bazauto/PicoDCC/docs/dccex-compliance-analysis.md

# PicoDCC DCC-EX Specification Compliance Analysis

**Reviewed against `main`**: 2026-08-20

> The authoritative list of what actually parses is the opcode table in
> [`architecture.md`](architecture.md), derived directly from
> `lib/PicoDCCEX/pico_dccexpacket.cpp`. This document gives the reasoning and the gap analysis;
> where the two disagree, the code wins.

## Overview
This document validates the PicoDCC project implementation against the [DCC-EX Native Commands Summary Reference](https://dcc-ex.com/reference/software/command-summary-consolidated.html). The analysis focuses on implemented features and identifies areas for future development.

## DCC-EX Protocol Commands Implemented ✅

### Power Management
**Status**: ✅ **IMPLEMENTED**

| Command | Description | Implementation Status | Location |
|---|---|---|---|
| `<0>` | Turn power off to all tracks | ✅ Implemented | `PicoDccExPacket::isPowerCommand()` |
| `<1>` | Turn power on to all tracks | ✅ Implemented | `PicoDccExPacket::isPowerCommand()` |
| `<0 MAIN>` | Turn off main track | ✅ Implemented | Track selection via `getTrack()` |
| `<1 MAIN>` | Turn on main track | ✅ Implemented | Track selection via `getTrack()` |
| `<0 PROG>` | Turn off prog track | ✅ Implemented | Track selection via `getTrack()` |
| `<1 PROG>` | Turn on prog track | ✅ Implemented | Track selection via `getTrack()` |

**Responses**: 
- ✅ `<p0>` / `<p1>` responses implemented via `getDccExPowerUpdate()`
- ✅ Track-specific responses: `<p1 MAIN>`, `<p1 PROG>`

**Implementation Details**:
- **Parser**: `PicoDccExPacket::decodePacket()` handles power commands
- **Execution**: `PicoDccController::dccexLoop()` processes power state changes
- **Hardware Control**: `PicoDccTrack::setPower()` controls GPIO pins

### Cab (Locomotive) Commands
**Status**: ✅ **CORE FEATURES IMPLEMENTED**

| Command | Description | Implementation Status | Location |
|---|---|---|---|
| `<t cab speed dir>` | Set locomotive speed/direction | ✅ Implemented | `PicoDccExPacket::isThrottleCommand()` |
| `<F cab funct state>` | Control locomotive functions | ✅ Implemented | `PicoDccExPacket::isFunctionCommand()` |
| `<!>` | Emergency stop all locomotives | ✅ Implemented | `PicoDccExPacket::isEmergencyStopCommand()` |

**Responses**:
- ✅ `<l cab 0 speed 0>` locomotive status responses via `getDccExCabUpdate()`
- ✅ Emergency stop sends `<l cab reg speedByte functMap>` for each active locomotive (DCC-EX compliant)
- ✅ `<O>` acknowledgment for accessory commands

**Implementation Details**:
- **Speed Control**: Full 0-126 speed range with direction bit
- **Function Control**: F0-F28 function support (RCN-212 compliant)
- **Emergency Stop**: Broadcast command (address 0x00, instruction 0x41)
- **Locomotive Management**: `PicoDccLocos` collection with automatic reminder system

### DCC Accessories
**Status**: ✅ **BASIC IMPLEMENTATION**

| Command | Description | Implementation Status | Location |
|---|---|---|---|
| `<a addr subaddr activate>` | Control accessory decoder | ✅ Implemented | `PicoDccExPacket::isAccesoryCommand()` |

**Responses**:
- ✅ `<O>` acknowledgment for accessory commands

**Implementation Details**:
- **Address/Subaddress Method**: Standard DCC accessory addressing
- **Raw Command Generation**: `getRawDccAccessoryCmd()` creates DCC packets

## DCC-EX Protocol Commands NOT Implemented ❌

### Track Manager Commands
**Status**: ❌ **NOT IMPLEMENTED**
- `<= trackletter mode [cab]>` - Configure Track Manager
- `<=>` - Request Track Manager configuration
- DC mode operations and frequency control

**Reason**: PicoDCC focuses on standard DCC operation, not multi-track management

### Configuration Variable (CV) Programming
**Status**: 🔄 **IN DEVELOPMENT**

| Command Category | Implementation Status | Notes |
|---|---|---|
| Programming Track CVs | 🔄 Infrastructure ready | `<W cv value>`, `<V cv value>`, `<R cv>`, `<B cv bit value>` |
| Main Track CV Programming | ❌ Not planned | `<w cab cv value>`, `<b cab cv bit value>` |
| CV Reading | 🔄 Infrastructure ready | ACK detection hardware in place |

**Implementation Status**:
- ✅ Hardware ACK detection ready (ADC-based current sensing)
- ✅ Programming track infrastructure (`PicoDccTrack` prog track)
- ✅ Method signatures defined in `PicoDccLoco` class
- ✅ Non-volatile storage for calibration values (`PicoConfigStorage`)
- 🔄 CV programming logic implementation in progress
- 🔄 DCC-EX CV command parsing in progress

### Programming Track Configuration Commands
**Status**: ✅ **IMPLEMENTED** (Runtime adjustable, persistable in maintenance mode)

| Command | Description | Implementation Status | Location |
|---|---|---|---|
| `<D ACK LIMIT mA>` | Set ACK detection current threshold | ✅ Implemented | Runtime config (default 60mA) |
| `<D ACK MIN us>` | Set minimum ACK pulse duration | ✅ Implemented | Runtime config (default 5000µs) |
| `<D ACK MAX us>` | Set maximum ACK pulse duration | ✅ Implemented | Runtime config (default 7000µs) |
| `<D SPEED28>` / `<D SPEED128>` | Select speed step mode | ✅ Implemented | 128 is the default. Extended with an optional trailing cab for a per-loco override, which DCC-EX does not have; the no-argument form JMRI sends is unchanged (#8) |

**Implementation Details**:
- **Runtime Adjustable**: Changes take effect immediately in RAM
- **Persistent Storage**: Saved to flash via `<E>` command (maintenance mode only)
- **Configuration Storage**: `PicoConfigStorage` manages NV storage in flash
- ⚠️ **ACK detection itself is not implemented on `main`.** These three commands tune and
  persist the *parameters* for it; nothing consumes them yet. The detection logic is being
  developed on the `programming` branch. Do not read "implemented" here as meaning a decoder
  acknowledgement can currently be detected.

**Not reachable**: `<D CONFIG ...>` and `<D CAL ...>` are implemented in
`lib/PicoDCCEX/pico_dccex_config.cpp` but never wired into the command path — the packet
validator accepts only `<D ACK ...>` and `<D SPEED28|SPEED128 [cab]>`. See
`docs/README.md` § Known gaps.

### EEPROM/Flash Storage Commands
**Status**: ✅ **IMPLEMENTED** (with safety restrictions)

| Command | Description | Implementation Status | Security |
|---|---|---|---|
| `<E>` | Save settings to flash/EEPROM | ✅ Implemented | 🔒 Maintenance mode only |

**Responses**:
- ✅ `<e SAVED>` - Flash write successful
- ✅ `<e FAILED>` - Flash write failed
- ✅ `<X>` - Command rejected (not in maintenance mode)

**Safety Design**:
- **Layout Maintenance Mode Required**: Prevents flash write during track operations
- **410ms Flash Write Block**: Both cores halt during write (all locos must be stopped)
- **Main Track Power Lockout**: Main track power disabled during maintenance mode
- **Programming Track Continues**: CV operations allowed during maintenance mode
- **LCD-Only Mode Entry**: Cannot enter maintenance mode via DCC-EX commands (operator presence required)

**Implementation Details**:
- **Flash Storage**: Last 4KB sector (0x101FF000) with CRC32 validation
- **Configuration Class**: `PicoConfigStorage` manages persistent parameters
- **Mode Management**: `PicoDCCController` enforces maintenance mode restrictions
- **Unsaved Changes Tracking**: System tracks runtime changes vs. flash-saved values

### System Information Commands
**Status**: ⚠️ **PARTIALLY IMPLEMENTED**

| Command | Description | Implementation Status | Notes |
|---|---|---|---|
| `<s>` | Version and hardware info | ⚠️ Planned | JMRI compatibility improvement |
| `<c>` | Request current measurements | ❌ Not planned | Hardware monitoring exists but not exposed |
| `<#>` | Number of supported cabs | ⚠️ Planned | JMRI compatibility improvement |

**JMRI Compatibility Notes**:
- JMRI queries `<s>` and `<#>` on startup
- Current behavior: Command timeout (JMRI waits ~3 seconds)
- **Planned**: Return proper responses to eliminate startup delays

### Advanced Features NOT Implemented
**Status**: ❌ **NOT REQUIRED FOR BASIC LAYOUT**

| Feature Category | Commands | Status | JMRI Impact |
|---|---|---|---|
| Turnouts/Points | `<JT>` (list), `<T>` (control) | ❌ Not implemented | Startup query timeout |
| Turntables | `<I>`, `<I id position>` | ❌ Not implemented | No impact |
| Sensors | `<Q>`, `<S>` | ❌ Not implemented | No impact |
| Outputs | `<Z>`, `<z>` | ❌ Not implemented | No impact |
| Routes/Automations | `<JA>` (list), `</>` (control) | ❌ Not implemented | Startup query timeout |
| Roster Management | `<JR>` (list) | ❌ Not implemented | Startup query timeout |
| WiFi Control | `<+>` commands | ❌ Not implemented | No impact |
| Fast Clock | `<JC>` | ❌ Not implemented | No impact |

**JMRI Startup Behavior**:
- **Issue**: JMRI queries list commands on startup (`<JT>`, `<JA>`, `<JR>`)
- **Current**: ~9 second startup delay (3 seconds per timeout)
- **Planned**: Return empty list responses to eliminate delays
  - `<jT>` - Empty turnout list
  - `<jA>` - Empty automation list  
  - `<jR>` - Empty roster list
- **Add/Modify Commands**: Return `<X>` error for unsupported operations

## Implementation Architecture

### Protocol Parsing
**Location**: `lib/PicoDCCEX/`
- **PicoDccEx**: Main command processor with UART input buffering
- **PicoDccExPacket**: Command parser and DCC packet generator
- **Support**: 14 test cases covering all implemented commands

### Command Execution
**Location**: `lib/PicoDCCController/`
- **Core 0 (dccexLoop)**: Processes DCC-EX commands and manages locomotive collection
- **Core 1 (dccLoop)**: Handles DCC packet transmission and safety monitoring
- **Queue-based**: Inter-core communication via hardware queue

### Hardware Interface
**Location**: `lib/PicoDCCTrack/`
- **PIO-based**: Hardware-accelerated DCC signal generation
- **Dual Track**: Independent main and programming track control
- **Safety Features**: Overcurrent protection, timing monitoring

## DCC-EX Compliance Summary

### ✅ Fully Compliant Areas
1. **Power Management** - Complete implementation with all track selections
2. **Basic Locomotive Control** - Speed, direction, functions, emergency stop
3. **DCC Accessories** - Basic accessory decoder control
4. **Protocol Responses** - Proper DCC-EX acknowledgments and status updates
5. **ACK Configuration** - Runtime adjustable programming track parameters (`<D ACK ...>`)
6. **Flash Storage** - EEPROM-equivalent storage with safety restrictions (`<E>`)

### ⚠️ Partially Implemented Areas
1. **CV Programming** - Infrastructure ready, command parsing in development
2. **System Information** - Basic queries needed for JMRI compatibility
3. **List Queries** - Empty list responses needed to prevent JMRI timeouts

### ❌ Not Implemented (By Design)
1. **Track Manager** - Multi-track configuration beyond main/prog
2. **Advanced Accessories** - Turnouts, turntables, sensors, outputs
3. **Network Features** - WiFi management, roster synchronization
4. **Automation** - Routes, EXRAIL integration
5. **Main Track CV Programming** - Operations track programming not supported

## Layout Compatibility Assessment

### ✅ **Suitable For**:
- **Basic DC Model Railway Control**: Full locomotive speed/direction/function control
- **Simple Accessory Control**: Basic turnout and signal control via DCC accessories
- **Multi-Locomotive Operation**: Automatic locomotive management and reminders
- **Emergency Safety**: Comprehensive emergency stop implementation

### ⚠️ **Limitations For**:
- **Decoder Programming**: Cannot program locomotive CVs (requires external programmer)
- **Complex Layouts**: No support for automated routes or advanced track management
- **System Integration**: Limited compatibility with full DCC-EX ecosystem features

### ❌ **Not Suitable For**:
- **Turnout Automation**: No support for DCC-EX turnout definitions and control
- **Sensor Integration**: No support for occupancy detection or automated responses
- **Advanced Diagnostics**: No current monitoring or system health reporting

## Future Development Recommendations

### Priority 1: JMRI Compatibility Improvements (Quick Wins)
1. **Empty List Responses** - Eliminate 9-second startup delay:
   - `<JT>` → `<jT>` (empty turnout list)
   - `<JA>` → `<jA>` (empty automation list)
   - `<JR>` → `<jR>` (empty roster list)
2. **Basic System Info**:
   - `<s>` → Version and track count response
   - `<#>` → Locomotive capacity response

### Priority 2: Essential for Complete DCC Operation
1. **CV Programming Implementation**:
   - Complete DCC-EX CV command parsing (`<W>`, `<V>`, `<R>`, `<B>`)
   - Implement programming track ACK detection logic
   - Integrate with existing `PicoDccLoco` CV method stubs
   - Add CV read/write test coverage

### Priority 3: Layout Enhancement (Optional)
1. **Turnout Support**: For layouts with DCC-controlled turnouts
2. **Current Monitoring API**: Expose existing hardware monitoring via `<c>`
3. **Diagnostic Commands**: Enhanced debugging and monitoring

## Testing Coverage

### ✅ **Comprehensive Test Coverage**
- **57 Total Tests** across all implemented components
- **9 Controller Tests** covering DCC-EX protocol compliance
- **14 Packet Tests** validating command parsing and responses
- **Dual-Mode Validation**: Ensures compatibility in both test and hardware environments

### Test Validation Results
- ✅ **Power Management**: All commands and responses tested
- ✅ **Locomotive Control**: Speed, direction, functions validated
- ✅ **Emergency Stop**: Broadcast command and queue clearing verified
- ✅ **Protocol Responses**: DCC-EX acknowledgment format compliance confirmed
- ✅ **Safety Systems**: Emergency cutoff and health monitoring validated

## Conclusion

**PicoDCC provides a robust, safety-focused implementation of core DCC-EX functionality** suitable for basic to intermediate model railway layouts. The implementation correctly handles the essential DCC-EX commands needed for locomotive control and basic accessory operation.

**Key Strengths**:
- ✅ Proper DCC-EX protocol compliance for implemented features
- ✅ Comprehensive safety systems and emergency procedures
- ✅ Efficient dual-core architecture with hardware acceleration
- ✅ Extensive test coverage ensuring reliability

**Current Limitations**:
- ❌ No CV programming capability (requires external decoder programmer)
- ❌ Limited to basic locomotive and accessory control
- ❌ No advanced layout automation features

**Recommendation**: PicoDCC is **suitable for your layout requirements** as stated, providing solid locomotive speed control, emergency stop, and basic accessory control with proper DCC-EX protocol compliance. The CV programming stubs provide a foundation for future enhancement if decoder programming becomes necessary.

---
*Analysis conducted against DCC-EX specification dated October 2025*
*PicoDCC implementation validated through comprehensive test suite*
