bazauto/PicoDCC/docs/DCC_Broken.png

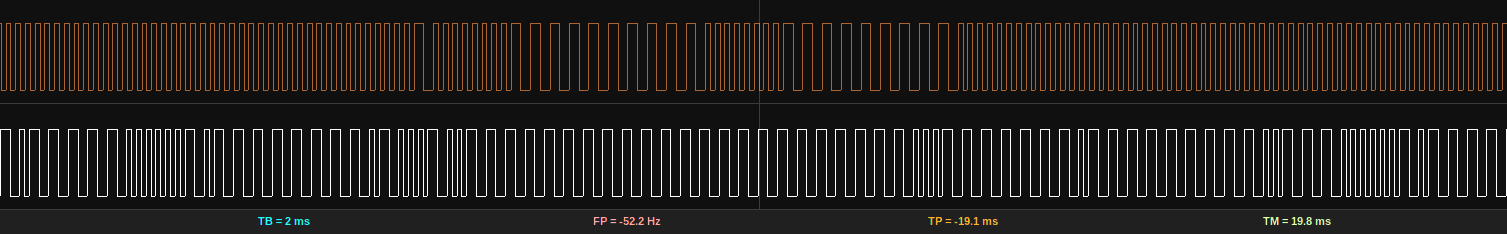
docs/DCC_Broken.png
