bazauto/PicoDCC/hardware/PicoDCC.kicad_pcb

## KiCad design hardware/PicoDCC.kicad_pcb (2026-09-28)

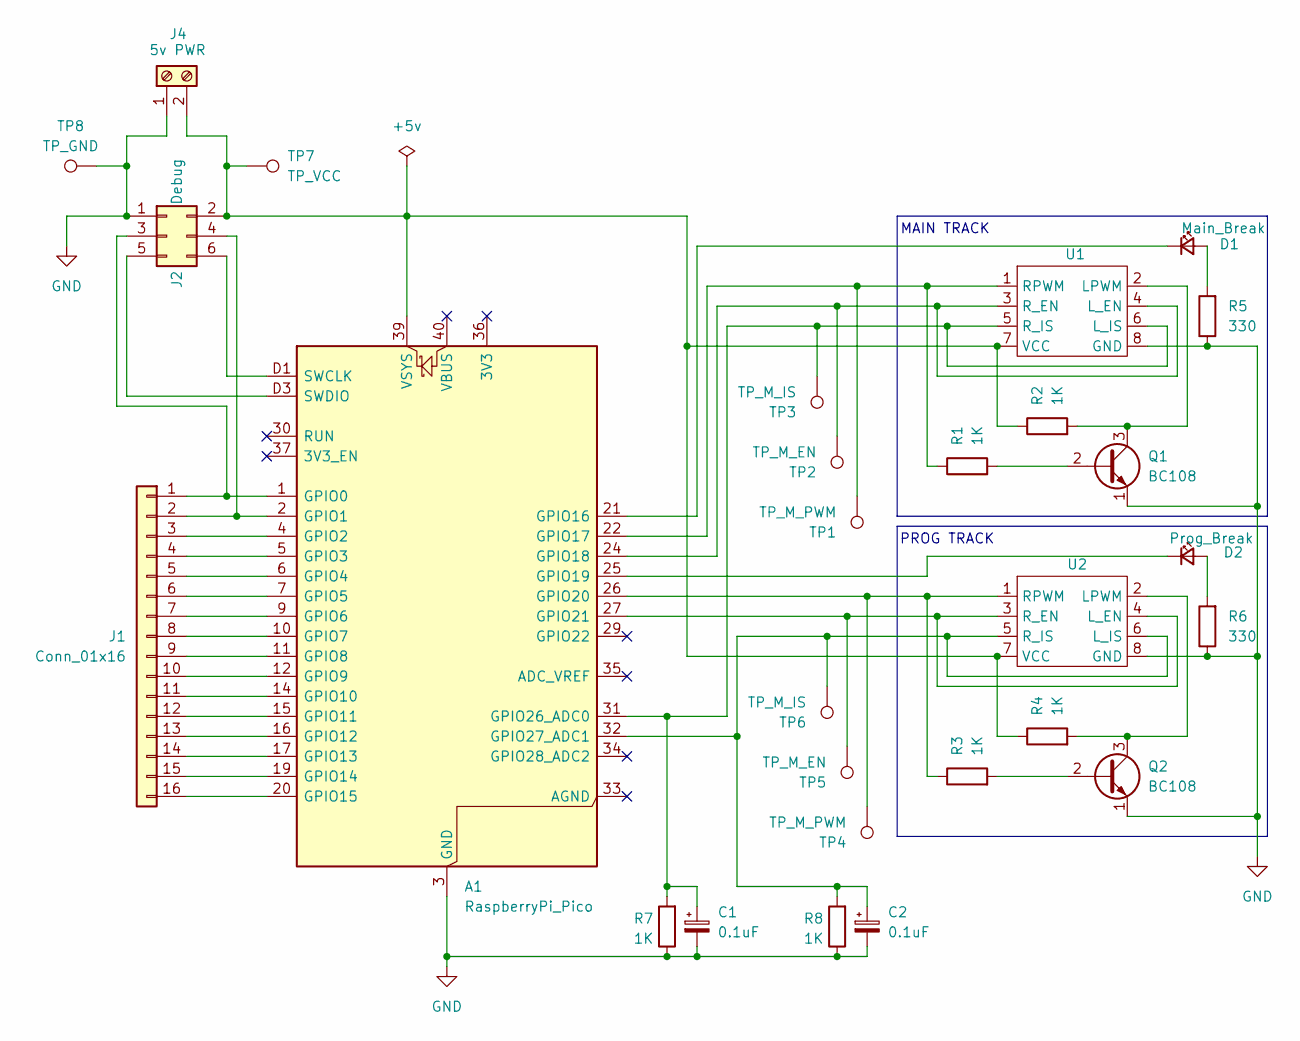
[picture p2: schematic PicoDCC.kicad_sch]

Parts:
A1: RaspberryPi_Pico; RaspberryPi_Pico_SMD_HandSolder
C1, C2: 0.1uF; CP_Radial_D4.0mm_P2.00mm
D1: Main_Break; LED_D3.0mm_Clear
D2: Prog_Break; LED_D3.0mm_Clear
J1: Conn_01x16; PinHeader_1x16_P2.54mm_Vertical
J2: Debug; PinHeader_2x03_P2.54mm_Vertical
J4: 5v PWR; TerminalBlock_RND_205-00012_1x02_P5.00mm_Horizontal
Q1, Q2: BC108; TO-18-3
R1, R2, R3, R4, R7, R8: 1K; R_Axial_DIN0207_L6.3mm_D2.5mm_P10.16mm_Horizontal
R5, R6: 330; R_Axial_DIN0207_L6.3mm_D2.5mm_P10.16mm_Horizontal
TP1, TP4: TP_M_PWM; PinSocket_1x01_P2.54mm_Vertical
TP2, TP5: TP_M_EN; PinSocket_1x01_P2.54mm_Vertical
TP3, TP6: TP_M_IS; PinSocket_1x01_P2.54mm_Vertical
TP7: TP_VCC; PinSocket_1x01_P2.54mm_Vertical
TP8: TP_GND; PinSocket_1x01_P2.54mm_Vertical
U1, U2: PinHeader_2x04_P2.54mm_Vertical

Connections:
GND: A1.3 (GND), A1.8 (GND), A1.13 (GND), A1.18 (GND), A1.23 (GND), A1.28 (GND), A1.38 (GND), A1.D2 (GND), C1.2, C2.2, J2.1, J4.1, Q1.1 (E), Q2.1 (E), R5.1, R6.1, R7.1, R8.1, TP8.1, U1.8 (GND), U2.8 (GND)
unnamed: A1.1 (GPIO0), J1.1, J2.3
unnamed: A1.2 (GPIO1), J1.2, J2.4
unnamed: A1.4 (GPIO2), J1.3
unnamed: A1.5 (GPIO3), J1.4
unnamed: A1.6 (GPIO4), J1.5
unnamed: A1.7 (GPIO5), J1.6
unnamed: A1.9 (GPIO6), J1.7
unnamed: A1.10 (GPIO7), J1.8
unnamed: A1.11 (GPIO8), J1.9
unnamed: A1.12 (GPIO9), J1.10
unnamed: A1.14 (GPIO10), J1.11
unnamed: A1.15 (GPIO11), J1.12
unnamed: A1.16 (GPIO12), J1.13
unnamed: A1.17 (GPIO13), J1.14
unnamed: A1.19 (GPIO14), J1.15
unnamed: A1.20 (GPIO15), J1.16
unnamed: A1.21 (GPIO16), D1.1 (K)
unnamed: A1.22 (GPIO17), R1.1, TP1.1, U1.1 (RPWM)
unnamed: A1.24 (GPIO18), TP2.1, U1.3 (R_EN), U1.4 (L_EN)
unnamed: A1.25 (GPIO19), D2.1 (K)
unnamed: A1.26 (GPIO20), R3.1, TP4.1, U2.1 (RPWM)
unnamed: A1.27 (GPIO21), TP5.1, U2.3 (R_EN), U2.4 (L_EN)
unnamed: A1.31 (GPIO26_ADC0), C1.1, R7.2, TP3.1, U1.5 (R_IS), U1.6 (L_IS)
unnamed: A1.32 (GPIO27_ADC1), C2.1, R8.2, TP6.1, U2.5 (R_IS), U2.6 (L_IS)
unnamed: A1.D1 (SWCLK), J2.6
unnamed: A1.D3 (SWDIO), J2.5
unnamed: A1.39 (VSYS), J2.2, J4.2, R2.1, R4.1, TP7.1, U1.7 (VCC), U2.7 (VCC)
unnamed: D1.2 (A), R5.2
unnamed: D2.2 (A), R6.2
unnamed: Q1.2 (B), R1.2
unnamed: Q1.3 (C), R2.2, U1.2 (LPWM)
unnamed: Q2.2 (B), R3.2
unnamed: Q2.3 (C), R4.2, U2.2 (LPWM)

Notes on the sheet:
PROG TRACK
MAIN TRACK

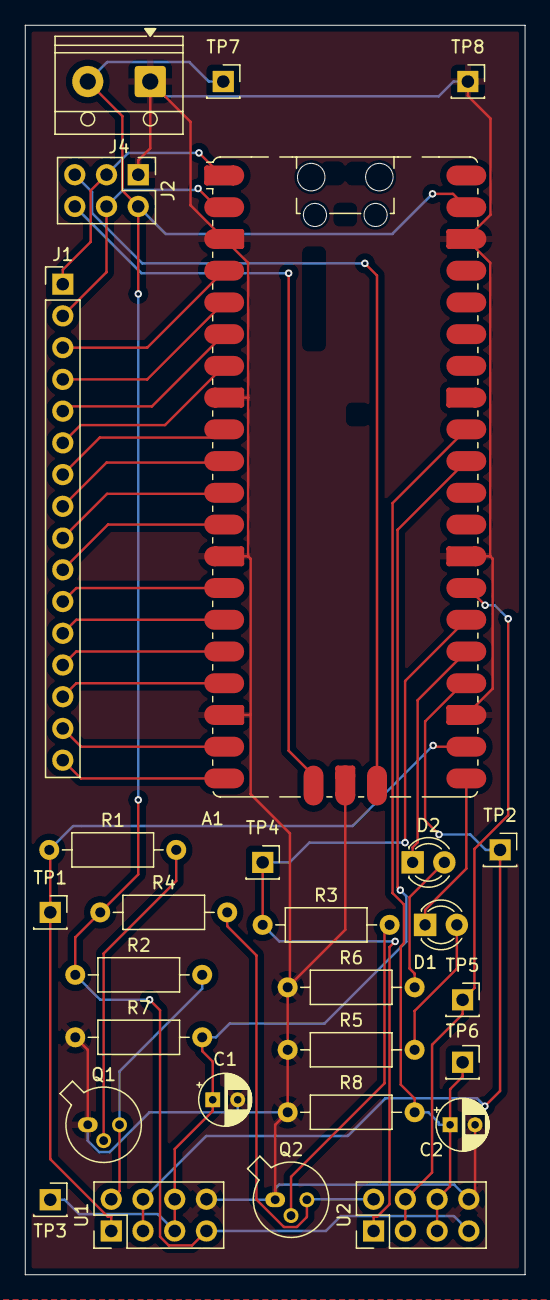
[picture p3: board PicoDCC.kicad_pcb from above]

Board: 2 copper layers, 40.0 x 100.0 mm, 28 parts (0 on the bottom side), 34 nets.
