bazauto/PicoDCC/test/pico_diagnostic_tests.cpp

/* test/pico_diagnostic_tests.cpp */
#define TEST_BUILD  // Ensure test mode is defined

#include <stdarg.h>
#include <stddef.h>
#include <setjmp.h>
#include <stdint.h>
#include <string.h>

extern "C" {
    #include <cmocka.h>
}

#include "../lib/pico_diagnostic.h"
#include "mocks.h"

// Mock timing control for tests
uint32_t mock_time_ms = 0;

// Mock globals (needed by mocks.cpp but not used in diagnostic tests)
std::vector<raw_dcc_cmd_t> queued_commands;
uint32_t mock_adc_reading = 0;
std::vector<std::string> uart_output_log;
bool track_power_states[2] = {false, false};
std::vector<uint64_t> sent_track_packets;

// Test fixture: Initialize and clear log buffer before each test
static int setup(void **state) {
    (void)state;  // Unused
    diag_log_init();
    return 0;
}

static int teardown(void **state) {
    (void)state;  // Unused
    diag_log_clear();
    return 0;
}

/**
 * Test: Buffer initialization
 */
static void test_log_buffer_init(void **state) {
    (void)state;
    
    // After init, buffer should be empty
    assert_int_equal(diag_log_get_count(), 0);
    
    // Should be able to get count without crash
    uint8_t count = diag_log_get_count();
    assert_int_equal(count, 0);
}

/**
 * Test: Adding single entry
 */
static void test_log_buffer_add_single(void **state) {
    (void)state;
    
    // Add one entry
    diagnostic_msg_t msg;
    msg.level = DIAG_ERROR;
    msg.timestamp = 1000;
    strcpy(msg.component, COMPONENT_TRACK);
    strcpy(msg.message, "Test error message");
    
    diag_log_add(&msg);
    
    // Should have 1 entry
    assert_int_equal(diag_log_get_count(), 1);
    
    // Retrieve and verify (using new thread-safe copy API)
    diagnostic_msg_t retrieved;
    assert_true(diag_log_get_entry(0, &retrieved));
    assert_int_equal(retrieved.level, DIAG_ERROR);
    assert_int_equal(retrieved.timestamp, 1000);
    assert_string_equal(retrieved.component, COMPONENT_TRACK);
    assert_string_equal(retrieved.message, "Test error message");
}

/**
 * Test: Adding multiple entries
 */
static void test_log_buffer_add_multiple(void **state) {
    (void)state;
    
    // Add 5 entries
    for (int i = 0; i < 5; i++) {
        diagnostic_msg_t msg;
        msg.level = DIAG_INFO;
        msg.timestamp = 1000 + i;
        strcpy(msg.component, COMPONENT_CONTROLLER);
        strcpy(msg.message, "Test message");
        diag_log_add(&msg);
    }
    
    // Should have 5 entries
    assert_int_equal(diag_log_get_count(), 5);
    
    // Verify order (oldest to newest)
    for (int i = 0; i < 5; i++) {
        diagnostic_msg_t entry;
        assert_true(diag_log_get_entry(i, &entry));
        assert_int_equal(entry.timestamp, 1000 + i);
    }
}

/**
 * Test: Circular buffer wrap-around
 */
static void test_log_buffer_wraparound(void **state) {
    (void)state;
    
    // Fill buffer beyond capacity (30 entries + 5 more)
    for (int i = 0; i < DIAG_LOG_BUFFER_SIZE + 5; i++) {
        diagnostic_msg_t msg;
        msg.level = DIAG_WARNING;
        msg.timestamp = 1000 + i;
        strcpy(msg.component, COMPONENT_POWER);
        strcpy(msg.message, "Wraparound test");
        diag_log_add(&msg);
    }
    
    // Should be capped at buffer size
    assert_int_equal(diag_log_get_count(), DIAG_LOG_BUFFER_SIZE);
    
    // Oldest entry should be at index 0, which is now entry #5 (0-4 were overwritten)
    diagnostic_msg_t oldest;
    assert_true(diag_log_get_entry(0, &oldest));
    assert_int_equal(oldest.timestamp, 1000 + 5);  // Entry 5 is now oldest
    
    // Newest entry should be at index 29, which is entry #34
    diagnostic_msg_t newest;
    assert_true(diag_log_get_entry(DIAG_LOG_BUFFER_SIZE - 1, &newest));
    assert_int_equal(newest.timestamp, 1000 + (DIAG_LOG_BUFFER_SIZE + 5 - 1));  // Entry 34
}

/**
 * Test: Invalid index returns NULL
 */
static void test_log_buffer_invalid_index(void **state) {
    (void)state;
    
    // Add 3 entries
    for (int i = 0; i < 3; i++) {
        diagnostic_msg_t msg;
        msg.level = DIAG_CRITICAL;
        msg.timestamp = 2000 + i;
        strcpy(msg.component, COMPONENT_CORE);
        strcpy(msg.message, "Critical error");
        diag_log_add(&msg);
    }
    
    assert_int_equal(diag_log_get_count(), 3);
    
    // Valid indices: 0, 1, 2
    diagnostic_msg_t entry;
    assert_true(diag_log_get_entry(0, &entry));
    assert_true(diag_log_get_entry(1, &entry));
    assert_true(diag_log_get_entry(2, &entry));
    
    // Invalid indices: 3, 4, 255
    assert_false(diag_log_get_entry(3, &entry));
    assert_false(diag_log_get_entry(4, &entry));
    assert_false(diag_log_get_entry(255, &entry));
}

/**
 * Test: Clear buffer
 */
static void test_log_buffer_clear(void **state) {
    (void)state;
    
    // Add 10 entries
    for (int i = 0; i < 10; i++) {
        diagnostic_msg_t msg;
        msg.level = DIAG_ERROR;
        msg.timestamp = 3000 + i;
        strcpy(msg.component, COMPONENT_DCCEX);
        strcpy(msg.message, "Error entry");
        diag_log_add(&msg);
    }
    
    assert_int_equal(diag_log_get_count(), 10);
    
    // Clear buffer
    diag_log_clear();
    
    // Should be empty
    assert_int_equal(diag_log_get_count(), 0);
    
    // Should return false for any index
    diagnostic_msg_t entry;
    assert_false(diag_log_get_entry(0, &entry));
}

/**
 * Test: LOG_* macros integration
 */
static void test_log_macros(void **state) {
    (void)state;
    
    // Use LOG macros to add entries
    LOG_INFO(COMPONENT_CONTROLLER, "Info message");
    LOG_WARNING(COMPONENT_TRACK, "Warning message");
    LOG_ERROR(COMPONENT_POWER, "Error message");
    LOG_CRITICAL(COMPONENT_CORE, "Critical message");
    
    // Should have 4 entries
    assert_int_equal(diag_log_get_count(), 4);
    
    // Verify severity levels
    diagnostic_msg_t entry;
    assert_true(diag_log_get_entry(0, &entry));
    assert_int_equal(entry.level, DIAG_INFO);
    assert_true(diag_log_get_entry(1, &entry));
    assert_int_equal(entry.level, DIAG_WARNING);
    assert_true(diag_log_get_entry(2, &entry));
    assert_int_equal(entry.level, DIAG_ERROR);
    assert_true(diag_log_get_entry(3, &entry));
    assert_int_equal(entry.level, DIAG_CRITICAL);
}

/**
 * Test: Component identifiers
 */
static void test_component_identifiers(void **state) {
    (void)state;
    
    // Test all component identifiers
    LOG_ERROR(COMPONENT_CONTROLLER, "Controller error");
    LOG_ERROR(COMPONENT_TRACK, "Track error");
    LOG_ERROR(COMPONENT_POWER, "Power error");
    LOG_ERROR(COMPONENT_QUEUE, "Queue error");
    LOG_ERROR(COMPONENT_CORE, "Core error");
    LOG_ERROR(COMPONENT_DCCEX, "DCCEX error");
    
    assert_int_equal(diag_log_get_count(), 6);
    
    // Verify components
    diagnostic_msg_t entry;
    assert_true(diag_log_get_entry(0, &entry));
    assert_string_equal(entry.component, "CONTROLLER");
    assert_true(diag_log_get_entry(1, &entry));
    assert_string_equal(entry.component, "TRACK");
    assert_true(diag_log_get_entry(2, &entry));
    assert_string_equal(entry.component, "POWER");
    assert_true(diag_log_get_entry(3, &entry));
    assert_string_equal(entry.component, "QUEUE");
    assert_true(diag_log_get_entry(4, &entry));
    assert_string_equal(entry.component, "CORE");
    assert_true(diag_log_get_entry(5, &entry));
    assert_string_equal(entry.component, "DCCEX");
}

/**
 * Test: Behavior before initialization
 */
static void test_uninitialized_buffer(void **state) {
    (void)state;
    
    // Clear initialization flag (simulate uninitialized state)
    extern diagnostic_log_buffer_t g_diag_log_buffer;
    g_diag_log_buffer.initialized = false;
    
    // Operations should be safe (no crash)
    diagnostic_msg_t msg;
    msg.level = DIAG_ERROR;
    msg.timestamp = 5000;
    strcpy(msg.component, COMPONENT_TRACK);
    strcpy(msg.message, "Should be ignored");
    
    diag_log_add(&msg);  // Should do nothing
    
    // Count should return 0
    assert_int_equal(diag_log_get_count(), 0);
    
    // Get entry should return false
    diagnostic_msg_t entry;
    assert_false(diag_log_get_entry(0, &entry));
    
    // Clear should be safe
    diag_log_clear();  // Should do nothing
    
    // Re-initialize for cleanup
    diag_log_init();
}

/**
 * Test: a reused slot keeps none of the previous entry's text (#18)
 *
 * log_diagnostic() now builds directly in the ring slot rather than in a
 * zeroed static, so the field copy has to zero-fill the tail itself. If it
 * only terminated the string, a short message landing in a slot that
 * previously held a long one would read back correctly but leave the old
 * text sitting past the NUL -- and the display reads fixed-size fields.
 */
static void test_reused_slot_has_no_residue(void **state) {
    (void)state;

    const char *long_message = "AAAAAAAAAAAAAAAAAAAAAAAAAAAAAAAAAAAAAAAA";  // 40 chars
    const char *short_message = "B";

    // Fill the ring, then wrap once so slot 0 is written a second time.
    for (int i = 0; i < DIAG_LOG_BUFFER_SIZE; i++) {
        log_diagnostic(DIAG_INFO, COMPONENT_TRACK, long_message);
    }
    log_diagnostic(DIAG_WARNING, COMPONENT_POWER, short_message);

    // The entry just written is the newest.
    diagnostic_msg_t newest;
    assert_true(diag_log_get_entry(diag_log_get_count() - 1, &newest));
    assert_int_equal(newest.level, DIAG_WARNING);
    assert_string_equal(newest.component, COMPONENT_POWER);
    assert_string_equal(newest.message, short_message);

    // Every byte after the terminator is zero, not the 'A's that were there.
    for (size_t i = strlen(short_message); i < DIAG_MESSAGE_MAX_LEN; i++) {
        assert_int_equal(newest.message[i], '\0');
    }
    for (size_t i = strlen(COMPONENT_POWER); i < DIAG_COMPONENT_MAX_LEN; i++) {
        assert_int_equal(newest.component[i], '\0');
    }
}

/**
 * Test: over-long fields are truncated and still NUL-terminated
 */
static void test_oversized_fields_are_truncated(void **state) {
    (void)state;

    char long_component[DIAG_COMPONENT_MAX_LEN * 2];
    char long_message[DIAG_MESSAGE_MAX_LEN * 2];
    memset(long_component, 'C', sizeof(long_component) - 1);
    long_component[sizeof(long_component) - 1] = '\0';
    memset(long_message, 'M', sizeof(long_message) - 1);
    long_message[sizeof(long_message) - 1] = '\0';

    log_diagnostic(DIAG_ERROR, long_component, long_message);

    diagnostic_msg_t entry;
    assert_true(diag_log_get_entry(0, &entry));
    assert_int_equal(entry.component[DIAG_COMPONENT_MAX_LEN - 1], '\0');
    assert_int_equal(entry.message[DIAG_MESSAGE_MAX_LEN - 1], '\0');
    assert_int_equal(strlen(entry.component), DIAG_COMPONENT_MAX_LEN - 1);
    assert_int_equal(strlen(entry.message), DIAG_MESSAGE_MAX_LEN - 1);
}

/**
 * Test: diag_log_add(nullptr) is a no-op rather than a fault
 *
 * The parameter became a pointer with #18, so there is now a null to reject.
 */
static void test_log_add_null_is_ignored(void **state) {
    (void)state;

    diag_log_add(NULL);
    assert_int_equal(diag_log_get_count(), 0);
}

/**
 * Test: the first sample is emitted immediately (#38)
 *
 * A bench session needs to see the baseline without waiting out a whole
 * interval, otherwise there is no way to tell a working sampler from a silent
 * one until ten minutes have passed.
 */
static void test_heap_first_sample_is_immediate(void **state) {
    (void)state;
    mock_reset_heap();
    mock_set_heap(1024, 2048, 4096);

    diag_sample_heap();

    assert_int_equal(diag_log_get_count(), 1);
    diagnostic_msg_t entry;
    assert_true(diag_log_get_entry(0, &entry));
    assert_int_equal(entry.level, DIAG_INFO);
    assert_string_equal(entry.component, COMPONENT_SYSTEM);
    assert_string_equal(entry.message, "heap used=1024 free=2048 arena=4096");
}

/**
 * Test: further samples inside the interval are suppressed
 *
 * The ring holds 30 entries. A sampler that emitted every pass would erase the
 * history it exists to build, in well under a second.
 */
static void test_heap_rate_limited_within_interval(void **state) {
    (void)state;
    mock_reset_heap();
    mock_set_heap(1, 2, 3);

    mock_time_ms = 0;
    diag_sample_heap();
    assert_int_equal(diag_log_get_count(), 1);

    for (int i = 0; i < 50; i++) {
        mock_time_ms += DIAG_HEAP_SAMPLE_INTERVAL_MS / 100;
        diag_sample_heap();
    }
    assert_int_equal(diag_log_get_count(), 1);

    // One tick past the interval and it speaks again.
    mock_time_ms = DIAG_HEAP_SAMPLE_INTERVAL_MS + 1;
    diag_sample_heap();
    assert_int_equal(diag_log_get_count(), 2);
}

/**
 * Test: a creeping arena is visible across samples
 *
 * This is the shape #38 is actually asking about -- `used` flat while `arena`
 * climbs is fragmentation, and the two numbers have to be readable apart.
 */
static void test_heap_reports_a_growing_arena(void **state) {
    (void)state;
    mock_reset_heap();

    mock_time_ms = 0;
    mock_set_heap(500, 100, 1000);
    diag_sample_heap();

    mock_time_ms = DIAG_HEAP_SAMPLE_INTERVAL_MS + 1;
    mock_set_heap(500, 100, 2000);   // same in use, arena doubled
    diag_sample_heap();

    assert_int_equal(diag_log_get_count(), 2);
    diagnostic_msg_t first, second;
    assert_true(diag_log_get_entry(0, &first));
    assert_true(diag_log_get_entry(1, &second));
    assert_string_equal(first.message, "heap used=500 free=100 arena=1000");
    assert_string_equal(second.message, "heap used=500 free=100 arena=2000");
}

/**
 * Test: a platform that cannot report the heap logs nothing
 *
 * Silence is right here. Logging zeroes would look like a heap that vanished,
 * and would burn ring entries saying nothing.
 */
static void test_heap_unavailable_logs_nothing(void **state) {
    (void)state;
    mock_reset_heap();
    mock_set_heap_available(false);

    diag_sample_heap();

    assert_int_equal(diag_log_get_count(), 0);
    mock_set_heap_available(true);
}

/**
 * Test: diag_read_heap(NULL) is refused rather than faulting
 */
static void test_heap_read_null_is_refused(void **state) {
    (void)state;
    mock_reset_heap();
    assert_false(diag_read_heap(NULL));
}

int main(void) {
    const struct CMUnitTest tests[] = {
        cmocka_unit_test_setup_teardown(test_log_buffer_init, setup, teardown),
        cmocka_unit_test_setup_teardown(test_log_buffer_add_single, setup, teardown),
        cmocka_unit_test_setup_teardown(test_log_buffer_add_multiple, setup, teardown),
        cmocka_unit_test_setup_teardown(test_log_buffer_wraparound, setup, teardown),
        cmocka_unit_test_setup_teardown(test_log_buffer_invalid_index, setup, teardown),
        cmocka_unit_test_setup_teardown(test_log_buffer_clear, setup, teardown),
        cmocka_unit_test_setup_teardown(test_log_macros, setup, teardown),
        cmocka_unit_test_setup_teardown(test_component_identifiers, setup, teardown),
        cmocka_unit_test_setup_teardown(test_uninitialized_buffer, setup, teardown),
        cmocka_unit_test_setup_teardown(test_reused_slot_has_no_residue, setup, teardown),
        cmocka_unit_test_setup_teardown(test_oversized_fields_are_truncated, setup, teardown),
        cmocka_unit_test_setup_teardown(test_log_add_null_is_ignored, setup, teardown),
        cmocka_unit_test_setup_teardown(test_heap_first_sample_is_immediate, setup, teardown),
        cmocka_unit_test_setup_teardown(test_heap_rate_limited_within_interval, setup, teardown),
        cmocka_unit_test_setup_teardown(test_heap_reports_a_growing_arena, setup, teardown),
        cmocka_unit_test_setup_teardown(test_heap_unavailable_logs_nothing, setup, teardown),
        cmocka_unit_test_setup_teardown(test_heap_read_null_is_refused, setup, teardown),
    };

    printf("Running Diagnostic Tests\n");
    return cmocka_run_group_tests(tests, NULL, NULL);
}
