bazauto/PicoDCC/(commit log)

2025-01-12 Finish more of the track processing and add setting for track signal pin as was hardcoded
2025-01-28 Debug session, fixes to get wifi throttle working
2025-01-29 First pass at adding uinit test framework
2025-10-08 Large refactor to minimise the work done by core 1 and hopefully improve stability.
    - Add DCC types, validation script, and comprehensive tests for PicoDCC
    - Created dcc_types.h to define raw DCC command structure.
    - Added Validate-DualMode.ps1 script for validating build modes and running tests.
    - Implemented test framework for PicoDCC controller and track functionalities.
    - Developed tests for command processing, power control, emergency stop, and idle packet generation.
    - Established global test variables for managing state across tests.
    - Ensured compatibility with both hardware and test builds through CMake configuration.
    [mocks.cpp, mocks.h, pico_dcc_controller_tests.cpp, pico_dcc_dccex_tests.cpp, pico_dcc_loco_tests.cpp, pico_dcc_locos_tests.cpp]
2025-10-08 Exclude Circuit design elements
2025-10-08 Fix test following hardware run that found 90% was a better over current value.
    [pico_dcc_track_tests.cpp]
2025-10-16 Implement core health monitoring and emergency power cutoff mechanism
2025-10-16 Enhance diagnostic logging and DCC-EX communication for improved error handling and compliance
    - Implemented a diagnostic logging system with severity levels and structured messages.
    - Updated DCC-EX communication to ensure consistent response handling across test and hardware modes.
    - Refactored code to replace direct UART outputs with logging macros for critical events.
    - Added emergency stop response handling for locomotives in compliance with DCC-EX specifications.
    - Documented compliance analysis for DCC-EX protocol commands and future development recommendations.
    [pico_dcc_controller_tests.cpp]
2025-10-16 Enhance PIO health monitoring with comprehensive failure detection and response mechanisms
    [pico_dcc_track_tests.cpp]
2025-10-16 Refactor build tasks and update CMake configuration for Pico SDK integration
    - Updated `.vscode/tasks.json` to streamline build, run, flash, and reset tasks for the Raspberry Pi Pico.
    - Enhanced `CMakeLists.txt` to include user home path handling and set default SDK versions.
    - Revised documentation in `architecture.md` to reflect updated test coverage metrics.
    - Modified `pico_dccexpacket.cpp` to improve packet decoding logic and validation handling.
    - Adjusted `pico_dccloco.cpp` to prioritize speed validation for more informative error messages.
    - Improved `pico_dcclocos.cpp` with thread-safe loco count retrieval and iterator management during loco removal.
    - Added new tests in `pico_dcc_l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
    [pico_dcc_controller_tests.cpp, pico_dcc_locos_tests.cpp]
2025-10-16 Refactor DCCEX response handling for consistent UART communication in test and hardware modes
2025-10-18 Enhance DCC controller and loco management with reminder rate limiting, throttle command updates, and thread-safe loco updates
2025-10-18 Refactor locomotive reminder generation to Core 1 for improved queue management and overflow prevention
    [mocks.cpp, mocks.h, pico_dcc_locos_tests.cpp]
2025-10-18 Enhance command handling in DCC loops by adjusting repeat logic and routing inter-core commands to the appropriate track queues
2025-10-19 Implement PicoConfigStorage for non-volatile configuration management
    - Added PicoConfigStorage class to handle configuration storage in the last 4KB of flash memory.
    - Implemented methods for loading, saving, and resetting configuration values with CRC32 checksum validation.
    - Defined configuration structure with magic number and versioning for integrity checks.
    - Created getters and setters for various configuration parameters including ADC conversion, ACK thresholds, and current limits.
    - Integrated test cases for default values, setting/getting parameters, save/load cycles, and checksum validation.
    - Introduced PicoDccExConfig class for handling configuration and calibration commands, in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
    [pico_config_storage_tests.cpp]
2025-10-19 LCD Phase 1 Changes - ready for initial hardware test
    Implement LCD display integration with LVGL support, including driver and UI components
2025-10-19 LCD Phase 2 Implement LVGL integration for diagnostic display and track status updates
2025-10-19 Fix display update mechanism by forcing screen redraw and processing LVGL timers
2025-10-19 LCD Phase 3 Enhance LCD display management with boot sequence and real-time track data integration
2025-10-19 LCD Phase 4 - Initial Touchscreen Implement touch input support for Phase 4 with CST328 controller and interactive buttons
2025-10-19 Implement touch interrupt handling and improve touch callback efficiency
2025-10-19 Enhance touch handling with debug logging in callback and interrupt handler
2025-10-19 Switch debug output to uart_puts to work with hardware test setup
2025-10-19 Add debug logging for touch input registration and read timer status
2025-10-19 Add debug logging for touch read timer configuration and remove timing checks
2025-10-19 Add LVGL tick increment for timer functionality in update method
2025-10-19 feat(lcd): Working touch calibration system with CST328
    - Fixed CST328 driver to use correct 16-bit register addresses (0xD000)
    - Fixed data format parsing (state field + proper coordinate extraction)
    - Added TouchCalibration class for 9-point calibration
    - Added serial command '<C>' to trigger calibration
    - Touch coordinates now map correctly with piecewise linear interpolation
    - Buttons respond correctly to touch input
    - All debug output cleaned up
    This commit preserves the working calibration system before simplification.
2025-10-19 refactor(lcd): Simplify touch to essential coordinate transform
    Removed calibration system (600+ lines) in favor of simple linear mapping.
    The corrected CST328 driver provides clean coordinates that only need
    axis swap and inversion - no complex piecewise interpolation needed.
    Changes:
    - Replaced piecewise calibration with 10-line linear formula in touchCallback()
    - Removed TouchCalibration class (touch_calibration.cpp/h)
    - Removed all calibration UI screens and methods from PicoDCCDisplay
    - Removed <C> serial command from DCC-EX packet processing
    - Removed calibration request handling from PicoDCCController
    - Deleted calibration documentation (3 files, ~18K lines)
    - Updated CMakeLists.txt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
2025-10-19 refactor(lcd): Remove all debug UART output from display code
    Cleaned up all uart_puts() debug messages that were polluting the DCC-EX
    command stream. The display and touch functionality is now stable, so
    debug output is no longer needed.
    Removed:
    - Touch initialization status messages
    - Touch timer configuration debug output
    - Button click debug messages (MAIN PWR, PROG PWR, RESET TRIPS, CALIBRATE)
    - Raw touch data periodic dumps (every 50 reads)
    - Power state transition debug messages
    The UART is now exclusively used for DCC-EX protocol communication,
    ensuring clean command/response flow for external controllers.
    Files changed:
    - lib/PicoDCCDisplay/pico_dcc_display.cpp
    - lib/PicoDCCDisp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
2025-10-20 Add LVGL-based display renderer and mock implementation for testing
    - Implemented `LvglRenderer` class for hardware rendering using LVGL.
    - Created `MockDisplayRenderer` class for unit testing without hardware dependencies.
    - Updated `PicoDCCDisplay` to integrate the new renderer and handle display initialization, boot sequence, and update logic.
    - Added unit tests for display initialization, boot sequence, update timing, and track status gathering using the mock renderer.
2025-10-20 Fix test mode build issue
    [pico_dcc_display_tests.cpp]
2025-10-20 Implement diagnostic log display feature with circular buffer and LVGL UI Result of hardware debug session
    - Removed the implementation plan document for the diagnostic log display feature.
    - Updated `pico_dcccontroller.cpp` to use a multicore-safe timer.
    - Added necessary includes in `lcd_driver.h`.
    - Enhanced `lvgl_renderer.cpp` to build formatted log text with safety limits and improved buffer management.
    - Modified `pico_dcctrack.cpp` to utilize a multicore-safe timer for health monitoring.
    - Refactored `pico_diagnostic.cpp` to implement a circular buffer for diagnostic messages with thread safety using semaphores.
    - Updated `pico_diagnostic.h` to define maximum lengths for component and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
2025-10-20 Fix test mode compatibility: Add time_us_32() mock and fix diagnostic test string assignments
    [mocks.cpp, mocks.h, pico_diagnostic_tests.cpp]
2025-10-20 Fix controller tests: Initialize diagnostic log buffer in test setup
    - Added diag_log_init() to setup() function
    - Added diag_log_clear() to teardown() function
    - Fixes test_core_health_monitoring and test_emergency_power_cutoff
    - All 9 controller tests now passing
    The diagnostic logging system requires initialization before use. Without
    this, log_diagnostic() silently ignores all calls, preventing CRITICAL
    messages from appearing in UART output for test validation.
    [pico_dcc_controller_tests.cpp]
2025-10-20 docs: Add Layout Maintenance Mode design and JMRI compatibility tracking
    - Updated implementation-complete-config-storage.md with hybrid runtime/persistent config design
    - Added Layout Maintenance Mode safety pattern to copilot-instructions.md
    - Documented DC mode danger (full speed) in safety-recommendations.md
    - Created dccex-jmri-compatibility-todos.md for JMRI integration tracking
    Layout Maintenance Mode prevents DC mode runaway during 410ms flash writes by:
    - Requiring main track power OFF before mode entry
    - LCD-only activation (no remote DCC-EX command)
    - Manual exit with main track staying OFF
    - Hybrid config: runtime adjustable (<D ACK ...>) vs persistent (<E> save)
2025-10-20 feat: Implement Layout Maintenance Mode state machine and hybrid config
    Core Components Implemented:
    - OperationMode enum (NORMAL, LAYOUT_MAINTENANCE) in PicoDCCController
    - Mode management: canEnterMaintenanceMode(), enterMaintenanceMode(), exitMaintenanceMode()
    - Main track power lockout enforcement in maintenance mode
    - Silent rejection of throttle/function/accessory commands during maintenance
    - Configuration access via getConfigStorage()
    Hybrid Configuration Architecture (PicoConfigStorage):
    - Runtime config (RAM): ACK threshold/durations adjustable via commands
    - Flash config (persistent): Calibration and safety limits
    - Unsaved changes tracking with hasUnsavedChanges() flag
    - discard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
2025-10-20 feat: Add DCC-EX commands for runtime config and maintenance mode
    Commands Implemented:
    - <D ACK LIMIT mA> - Set ACK detection threshold (runtime, immediate effect)
    - <D ACK MIN us> - Set minimum ACK pulse duration (runtime)
    - <D ACK MAX us> - Set maximum ACK pulse duration (runtime)
    - <E> - Save configuration to flash (maintenance mode only, 410ms blocking)
    - <s> - Enhanced status with mode, unsaved changes, ACK config
    - <#> - Locomotive capacity report (50 locos)
    Status Command Response (<s>):
    - Version info: DCC-EX V-5.0.0 / PICODCC / BUILD Oct 20 2025
    - Track power: <p1/p0 MAIN> <p1/p0 PROG>
    - Mode indicator: <iM> (maintenance) or <iN> (normal)
    - Unsaved changes: <u> if config modified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
2025-10-20 refactor: Remove PicoDCC protocol extensions from status command
    Based on JMRI testing feedback:
    - Random text is silently ignored by JMRI
    - <U ...> shows as unrecognized in JMRI log
    - <X> correctly interpreted as operation failed
    - Protocol extensions require Java driver fork (not worth effort)
    - Removed <iM>/<iN> mode indicators from <s> response
    - Removed <u> unsaved changes indicator from <s> response
    - Removed ACK config display from <s> response
    - Status command now returns standard DCC-EX format only
    Design Decision:
    - Mode and unsaved changes displayed on LCD only
    - No DCC-EX protocol pollution
    - Maintains JMRI compatibility without driver modifications
    - <D ACK ...> comma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
2025-10-20 docs: Update JMRI compatibility notes with testing feedback
    Real-world JMRI Testing Results (October 20, 2025):
    - Random text: Silently ignored (no log entry)
    - <U ...>: Shows as unrecognized command in log (debug use)
    - <X>: Correctly interpreted as operation failed
    - Protocol extensions: Require Java driver fork (not viable)
    Documentation Updates:
    - Removed references to <iM>/<iN>/<u> in status response
    - Documented design decision: LCD-only for mode/unsaved indicators
    - Kept <D ACK ...> commands (diagnostic namespace, JMRI ignores)
    - Kept <E> command (simple, unlikely to conflict)
    - Added rationale for clean protocol approach
    Key Insight:
    Maintaining JMRI compatibility without driver fo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
2025-10-20 Implement LCD UI for Layout Maintenance Mode
    Phase 3 complete: User-accessible maintenance mode screens
    - Extended TrackStatus with maintenance_mode_active and has_unsaved_changes
    - Updated gatherTrackStatus() to query mode and config state
    - Added 5 new methods to IDisplayRenderer interface
    - Implemented settings screen with maintenance mode button
    - Implemented maintenance mode screen with save/exit controls
    - Added reusable modal dialog system for user confirmations
    - Added event handlers for all UI interactions
    - Added mock renderer stubs for test mode compatibility
    UI Flow:
    1. Main screen -> Settings button -> Settings screen
    2. Settings -> Maintenance Mode button -> Safety c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
2025-10-20 docs: Update config storage doc with completed Phase 3 (LCD UI)
    Marked Layout Maintenance Mode as complete:
    - Phase 1: Core state machine
    - Phase 2: DCC-EX commands
    - Phase 3: LCD Display UI
    Added detailed implementation notes for Phase 3 including:
    - 7 modified files
    - 4 UI screens (settings, entry modal, maintenance, exit warning)
    - 6 event handlers
    - Reusable modal dialog system
    - Test mode stub implementations
    - Lessons learned from ARM Cortex-M memory safety
    Status: Ready for CV Programming Phase 1 (ACK Detection)
2025-10-20 Add unit tests for Layout Maintenance Mode
    Added 4 new controller tests (13 13 total, +4 MM tests):
    - test_maintenance_mode_entry_requirements: Entry validation
    - test_maintenance_mode_power_lockout: Main track power enforcement
    - test_maintenance_mode_command_rejection: Throttle/function/accessory rejection
    - test_maintenance_mode_exit: Mode exit and restore normal operation
    All tests passing with GCC/Ninja build configuration.
    Note: Config command tests (<D ACK>, <E>, <s>) deferred to Phase 2.
    These will be added when DCC-EX config command handlers are implemented.
2025-10-21 Update PicoDCC configuration handling and display improvements
    - Adjusted flash storage offset for 4MB flash configuration.
    - Enhanced PicoDccController to handle configuration commands more efficiently, including ACK LIMIT, ACK MIN, and ACK MAX commands.
    - Updated PicoDccExPacket to parse and validate configuration commands with appropriate ranges.
    - Added unit tests for configuration commands to ensure correct parsing and validation.
    - Improved the display modal for maintenance mode entry, making it non-blocking and enhancing button responsiveness.
    - Removed deprecated pico_dcc_display.cpp file and refactored related display logic.
    [pico_dcc_packet_tests.cpp]
2026-08-20 chore: establish CLAUDE.md as the single source of project rules, add CI (#9)
    Replaces the copied layout-orchestration Claude config with one built for this
    firmware repo, retires the duplicated Copilot rules file, and adds the CI the PR
    workflow assumes exists.
    - CLAUDE.md: build commands for both modes, the shared build/ cache-clearing trap,
    the non-negotiable safety and ARM Cortex-M rules, component ownership, and the
    transport facts that are easy to get wrong (uart0 for DCC-EX, USB CDC for printf).
    - .github/copilot-instructions.md reduced to a pointer; rules live in one place now.
    - .github/workflows/ci.yml: test build + ctest on every push and PR.
    - .claude: agents and skills rewr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
2026-08-20 docs: refresh status against the code, and record what does not work (#10)
    The documentation had drifted far enough that several files describe features
    as complete when they are not reachable at runtime. This reconciles every
    status claim against main and records the gaps rather than papering over them.
    Findings:
    - PicoDccExConfig is dead code. <D CONFIG ...> and <D CAL ...> handlers exist
    in lib/PicoDCCEX/pico_dccex_config.cpp and compile into PicoDCCEX, but the
    class is never constructed and the packet validator accepts only <D ACK ...>.
    implementation-complete-config-storage.md and calibration-guide.md both
    describe these commands as working.
    - CV programming methods in pico_dc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
2026-08-21 test: rebuild the mock layer and pin the DCC wire format (#19)
    A full review filed eight defects (#11-#18). The suite could not have caught
    most of them: all queues shared one global object with no capacity, the ADC
    mock discarded the selected channel, every semaphore was a no-op, and assert()
    was an empty function. Each of those made a filed issue unobservable.
    Mocks now model behaviour rather than signatures - per-queue ring buffers with
    real capacity, per-channel ADC readings, counting semaphores that record an
    acquire that would have blocked, and an assert() that records failures. Two
    further mock bugs surfaced on the way: PIO word pairing used an alternating
    toggle, so a short packet s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
    [mocks.cpp, mocks.h, pico_dcc_controller_tests.cpp, pico_dcc_loco_tests.cpp, pico_dcc_locos_tests.cpp, pico_dcc_track_tests.cpp, pico_dcc_wire_format_tests.cpp]
2026-08-21 chore: point dual-mode validation at the current toolchain
    Validate-DualMode.ps1 was written against the Pico SDK v1.5.1 installer
    layout and had been warn-and-skipping its hardware branch on a ~/.pico-sdk
    install. Resolve the SDK and ARM toolchain from PICO_SDK_PATH /
    PICO_TOOLCHAIN_PATH, falling back to the newest install under ~/.pico-sdk.
    Three other things were making the script quieter than it looked:
    - The test list was hardcoded to six executables; there are ten suites, so
    it reported "6/6 passed" while never running config storage, display,
    diagnostic or wire format. Use ctest instead, which cannot drift.
    - It always exited 0, so it could not gate a commit.
    - ErrorActionPrefer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
2026-08-21 docs: provision the Linux bench machine, and correct the OpenOCD story (#21)
    Hardware access moves off the VS Code Raspberry Pi extension and onto SSH.
    The extension had been doing the deployment and starting OpenOCD invisibly,
    which is why CLAUDE.md documented a long-running OpenOCD daemon on telnet
    port 50002. There is no such daemon and there never was - nothing listens on
    50002, 3333 or 4444 unless OpenOCD is explicitly launched. Both CLAUDE.md and
    docs/README.md now point at the real recipes.
    Add scripts/provision-bench.sh, idempotent and host-side only. It never
    flashes, never attaches a debugger and never touches the board. It installs
    the one genuinely missing package, writes udev r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
2026-08-21 fix: make ctest load the runtime the test binaries were built against (#22)
    Every unit test was failing with exit code 0xc0000139 when ctest ran from
    Git Bash, while the same binaries passed from PowerShell. That is
    STATUS_ENTRYPOINT_NOT_FOUND: the executables could not load their C++
    runtime and died before reaching main(). Not a test failure at all.
    add_cmocka_test_environment() bakes a snapshot of the configure-time PATH
    into each test's ENVIRONMENT property, and ctest *replaces* PATH with that
    snapshot when the test runs. The calling shell's PATH is ignored, so
    exporting PATH before invoking ctest cannot fix it. When the snapshot
    carries Git's mingw64 bin ahead of msys64 ucrt64, the tes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
2026-08-22 feat: script bench deploy and debug, split by whether they touch the board (#23)
    * feat: script bench deploy and debug, split by whether they touch the board
    Deploying firmware was a hand-run recipe in docs/bench-machine-setup.md, and
    reconstructing it cost a large amount of context every time: resolve the
    toolchain, clear the shared CMake cache, cross-build, check the image cannot
    reach the config sector, copy it over, verify it landed intact. All of that is
    mechanical, so it is now scripts.
    The split is the point. scripts/Deploy-Firmware.ps1 and `bench.sh inventory`
    never touch the board and are on the allowlist, so they run unattended. Every
    operation that reaches the hardware is a sepa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
2026-08-22 feat: bring the updated LCD UI across from the programming branch (#24)
    The LVGL renderer was rewritten on the `programming` branch a year ago and never
    reached main, so a board flashed from main shows a much older UI. That work is
    independent of the CV programming experiments it happens to sit next to, so this
    extracts just the display side.
    Taken across:
    - the renderer rewrite -- new theme colours, reworked diagnostic screen layout
    and power buttons
    - current readings converted with the calibrated ADC-to-mA factor from
    PicoConfigStorage instead of a hardcoded `* 1000.0f`, which was simply wrong
    - the packet counter replaced by a smoothed packets-per-second rate; the old
    display cla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
    [pico_dcc_display_tests.cpp, pico_dcc_track_tests.cpp]
2026-08-22 fix: stop scp silently transferring nothing on Windows (#26)
    `Deploy-Firmware.ps1` staged nothing to the bench. scp exited 0, printed nothing,
    and left the previous image in place.
    scp reads a Windows absolute path as a remote spec, so `E:\Development\...` parses
    as host `E` with path `\Development\...`. Both sources and the destination then
    look remote, scp attempts a remote-to-remote copy, and it gives up without a word.
    Run scp from the project root and hand it colon-free relative paths so the sources
    are unambiguously local.
    The reason this went unnoticed is worth recording. The post-transfer check --
    comparing sha256 on both ends -- was passing by coincidence: the image being
    staged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
2026-08-22 fix: stop the safety monitors firing a false cutoff on every boot (#27)
    Every boot logged three CRITICAL entries to the LCD:
    CRIT POWER: Emergency power cutoff activated
    CRIT CONTROLLER: DCC timing violation detected
    CRIT CORE: Core 1 heartbeat failure detected
    All three are one cascade, and it fires on the very first pass of the Core 0 loop.
    `last_core1_check` was baselined to 0 in the constructor, but construction happens
    long before the loop starts -- LCD init and the boot sequence run in between, and
    `multicore_launch_core1()` is not called until after them. By the first pass the
    clock is already tens of milliseconds past that baseline, so the 50ms check runs
    immediately.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
    [pico_dcc_controller_tests.cpp]
2026-08-22 fix: stop announcing ourselves as an Arduino Mega (#28)
    PicoDccEx's constructor sent this on the command UART at every startup:
    <iDCC-EX V-4.0.1 / MEGA / STANDARD_MOTOR_SHIELD / G-9db6d36>
    A literal left over from upstream DCC-EX during bring-up. It is not untidy, it is
    false: JMRI reading that banner would believe it was connected to a DCC-EX 4.0.1
    command station on an Arduino Mega with a standard motor shield, and size up its
    capabilities accordingly.
    Worse, the firmware reported two different identities depending on how you asked.
    Startup announced the Mega; <s> answered
    <iDCC-EX V-5.0.0 / PICODCC / BUILD Oct 20 2025>
    so what a client believed depended on whether it caught t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
    [pico_dcc_controller_tests.cpp, pico_dcc_dccex_tests.cpp]
2026-08-22 feat: build the version string from the git hash instead of hardcoding it (#29)
    * feat: build the version string from the git hash instead of hardcoding it
    The DCC-EX identity carried a hardcoded "BUILD Oct 20 2025" that never changed,
    so the one field that should tell you which image is on the board told you nothing.
    It actively misled: the board reported that date after every flash today.
    Extracted from the `programming` branch, where this was built and never brought
    across. `cmake/generate_version.cmake` produces `version.h` with the build date and
    `git rev-parse --short HEAD`, and `PICODCC_IDENTITY` is now that generated string.
    Two changes from the version on `programming`:
    * It e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
2026-08-22 Give each build mode its own tree, and stop the test gate reporting false greens (#30)
    * fix: give each build mode its own tree, and stop the test gate reporting false greens
    build/ was shared between test and hardware mode. Switching modes needed the
    cache cleared, and anything that reconfigured behind your back moved the whole
    tree to the other mode. That was slow. It was also unsound.
    Hardware mode never adds test/, so nothing calls enable_testing(), so CMake does
    not rewrite the top-level CTestTestfile.cmake -- it leaves the previous one in
    place, still listing subdirs("test") and still pointing at the old binaries. Any
    hardware-configured tree therefore returned "100% tests passed, 10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
2026-08-22 test: add end-to-end PIO wire-format tests (currently red)
    Adds a suite that closes the loop between packet packing and the bits that
    reach the rails. Every existing suite stops at raw_dcc_cmd_t.data[] or at
    cmd_data -- values on this side of the PIO -- which is why #31 was invisible:
    correct data[] packed one byte low still produced a corrupt waveform.
    The suite drives the real PicoDccTrack::sendCommand(), takes the words it
    pushed to the FIFO from the mock, executes the assembled dcc.pio against them,
    and decodes the waveform back into bits and bytes.
    The emulator runs pioasm's output (test/dcc_pio_program.hex) rather than a
    transcription, so it cannot drift from the program that runs on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
    [pico_dcc_pio_tests.cpp, pio_emulator.cpp, pio_emulator.h]
2026-08-22 fix: correct DCC packet packing and the PIO packet end bit
    Turns the previous commit's suite green. Two independent defects, both
    invisible to every test that stopped at data[] or cmd_data.
    #31 -- packing off by one byte
    The payload's position inside the 64-bit PIO word is a property of that
    word's layout: two header bytes, so the payload starts at byte 5. It was
    being derived from DCC_MAX_DATA_BYTES instead, which is a different
    quantity that merely used to coincide. When 92c341e changed that constant
    from 6 to 5 the expression silently started writing the payload one byte
    low, so the PIO transmitted an uninitialised 0x00 as the first byte and
    never reached the checksum. Every packet on t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
    [pico_dcc_controller_tests.cpp]
2026-08-22 fix: restore main track overcurrent protection and correct the current-monitoring block
    Fixes #14 and #36, which are the same fifteen lines of PicoDccTrack::loop().
    #14 -- the main track's overcurrent trip was inoperative. The ADC mux is shared
    between the two tracks and adc_select_input() was called once, in the
    constructor. PicoDccController builds main first and prog second, so the mux was
    left on the programming track's channel for the life of the firmware and both
    tracks read it. A dead short on the main track produced no rise on that channel
    and never tripped; a short on the programming track cut main track power as a
    side effect. loop() now selects its own channel immediately before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
    [mocks.cpp, mocks.h, pico_dcc_track_tests.cpp]
2026-08-22 fix: stop the millisecond clock wrapping every 71.6 minutes
    Fixes #32.
    `time_us_32() / 1000` was used throughout as a millisecond clock. Unsigned delta
    arithmetic (`now - then`) survives counter wrap only when the counter wraps at
    2^32. `time_us_32()` does; dividing by 1000 first produces a value that wraps at
    4,294,967 -- every 71.6 minutes of uptime. Across that boundary the subtraction
    yields roughly 2^32 instead of a small positive delta, and every timeout in the
    firmware fires at once.
    Observed in operation: both tracks powered off with "DCC timing violation
    detected" and nothing turning them back on. The recovery is asymmetric, which is
    what made it baffling -- the next pass agrees a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
    [pico_dcc_controller_tests.cpp, pico_dcc_display_tests.cpp]
2026-08-22 docs: record the dcc_millis() rule and refresh test counts
    CLAUDE.md gains a seventh non-negotiable rule: dcc_millis() is the only
    millisecond clock, and time_us_32() / 1000 must never be written again. That is
    the whole of #32, and the pattern had already been copied into five files.
    docs/architecture.md gains the same under Timing Safety. Test counts updated to
    167 (Controller 19 -> 22) across CLAUDE.md, docs/architecture.md, docs/README.md
    and docs/vscode-test-integration.md.
2026-08-23 fix: validate throttle commands before they reach the rails (#43)
    * fix: validate throttle commands before they reach the rails
    Fixes #11. Fixes #12. Fixes #16. Fixes #2. Fixes #1.
    Five safety defects in the DCC-EX command validation path, all in the same lines,
    so all fixed together. Implemented from docs/plans/throttle-validation-plan.md.
    #11 -- <t cab -1 dir> is DCC-EX emergency stop. getSpeed() returns int, no range
    check was applied, and -1 passed into a uint8_t became 255, which the 28-step
    encoder masked to 127: the estop command accelerated the locomotive to full
    speed. It now encodes a real per-loco emergency stop, 0x41 | direction -- the
    same instruction byte as the existing <!>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
    [pico_dcc_controller_tests.cpp, pico_dcc_loco_tests.cpp, pico_dcc_locos_tests.cpp, pico_dcc_packet_tests.cpp, pico_dcc_wire_format_tests.cpp]
2026-08-23 docs: adopt gh-stack for stacked PRs, and record the workflow (#44)
    Two branches in flight that touch the same lines is the normal case in this
    repo, not the exception: almost every change edits the test counts in four
    documentation files, so two independent branches off main conflict on merge even
    when the code does not overlap.
    This was hand-rolled for #40/#41 by setting #41's base to #40's branch. It worked
    until #40 merged, at which point #41's branch still carried #40's pre-rebase
    commit, GitHub reported CONFLICTING, and it needed a manual rebase and
    force-push. gh-stack does the restacking and retargeting itself.
    Records the commands, the non-interactive caveat (submit needs --auto o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
2026-08-23 fix: answer <X> on every rejected command (#47)
    Partially addresses #4.
    A rejected command that draws no reply is indistinguishable from one that
    worked, from one lost in transit, and from a hung station. The orchestrator on
    the other end of this link is headless and not in the room with the LCD, and its
    first rule is that uncertainty must halt movement -- it cannot act on a fault it
    is never told about.
    <X> is the DCC-EX generic rejection ("a command sent that is invalid has a
    response of <X>"), and the firmware already used it for the maintenance-mode
    power-on lockout and the config commands. This applies the same rule everywhere.
    Four rejection sites, all of which were silent:
    1. Vali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
    [pico_dcc_controller_tests.cpp, pico_dcc_dccex_tests.cpp]
2026-08-23 fix: reject the deprecated 4-field <t>, and correct the <l> speed byte (#49)
    Fixes #7. Fixes the reply half of the wire format.
    ## The 4-field throttle form
    sscanf stops as soon as its format is exhausted, so `sscanf(buffer, "%*c %d %d
    %d", ...) == 3` accepted the deprecated `<t REGISTER CAB SPEED DIR>` form and
    silently ignored the fourth field. Every field shifted one place left:
    <t 1 3 50 1> intended loco 3, speed 50, forward
    parsed as cab 1, speed 3, direction 50
    Confirmed on hardware before the fix: the station replied `<l 1 0 2 0>` --
    accepted, for loco 1. It was only ever caught when the real address exceeded the
    speed limit, so every loco addressed 1..126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
    [pico_dcc_controller_tests.cpp, pico_dcc_dccex_tests.cpp, pico_dcc_packet_tests.cpp, pico_dcc_wire_format_tests.cpp]
2026-08-23 fix: encode speed 0 as a controlled stop, not an emergency stop (#51)
    The 28-step instruction byte is 01DCSSSS, where the 5-bit speed value is
    (SSSS << 1) | C. Value 0 is the controlled stop; 1 and 3 are emergency
    stop; 2 is the alternate stop; a moving step N is value N + 3.
    generateThrottleCommand() built that value with an expression written for
    moving steps only:
    code28 = ((speed28 + 3) / 2) | ((speed28 & 1) ? 0 : 16)
    At speed28 == 0 that is (3 / 2) | 16 == 17, i.e. value 3 -- an emergency
    stop. So <t N 0 D>, the most frequently sent command in the system, put an
    emergency stop on the rails. Every ordinary stop slammed the locomotive to
    a halt instead of letting it decelerate unde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
    [pico_dcc_controller_tests.cpp, pico_dcc_loco_tests.cpp, pico_dcc_locos_tests.cpp, pico_dcc_wire_format_tests.cpp]
2026-08-23 fix: pace Core 1 on the main track alone, not on both PIO FIFOs (#52)
    Core 1 services both tracks in one pass and both passes ended in a blocking
    FIFO write, so the pass could only iterate as fast as the slower of the
    two. The programming track is the slower one -- DCC_PROG_PREAMBLE 20
    against DCC_MAIN_PREAMBLE 14, about 0.7ms more per packet -- so the main
    track was refilled at the programming track's rate while draining at its
    own faster one. Its TX FIFO trended empty, and an empty FIFO does not go
    quiet: the PIO stalls at `pull block` holding side 1, so the signal pin
    parks high and puts DC on the rails (#34).
    Measured on a scope at the GPIO, 2026-08-23. Main track inter-packet high
    of 2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
    [mocks.cpp, mocks.h, pico_dcc_track_tests.cpp]
2026-08-23 fix: make the inter-packet gap a legal bit instead of 203us of DC (#53)
    The gap between packets was two `side 1` delays -- 116us of high with no
    low half. Side-set is `opt`, so the four cycles of pull/out/out/jmp at the
    wrap carry that level too, and then the first preamble instruction adds its
    own 58us high. The line was continuously high for 203us and then dropped
    for 58us.
    Two consequences. A decoder sees halves that disagree, so it resynchronises
    and consumes the first preamble bit -- DCC_MAIN_PREAMBLE 14 emits 15, which
    left exactly the S-9.1 minimum of 14 with nothing spare. And an H-bridge
    driven from that pin put 203us of DC on the rails at every packet boundary,
    which is what the D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
    [pico_dcc_pio_tests.cpp, pio_emulator.cpp, pio_emulator.h]
2026-08-23 deploy: stop layout-orchestrator around flash and dccex, and restart it (#54)
    /dev/picodcc-dccex is a single exclusive channel and layout-orchestrator holds
    it open for the life of the service. That made the post-deploy health check
    fail on this deploy:
    FAIL port busy held by pid 340260 (MainThread)
    which reads like a firmware fault and is not. Flashing has the same problem
    from the other side: it resets the board underneath a connection the
    orchestrator still thinks is live.
    scripts/bench-orchestrator.sh holds the stop/restart, and bench.sh prepends it
    to whichever bench-*.sh it pipes over, so there is one copy rather than one per
    caller. It defines functions only, so prepending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
2026-08-24 docs: release under MIT, and attribute the third-party components
    The repository has been public since 2024 with no LICENSE file, which means
    default copyright applied: all rights reserved, and nobody could legally use,
    copy or modify the firmware. Release it under MIT.
    MIT is unobstructed here. Every dependency is permissive -- LVGL is MIT, the
    Pico SDK is BSD-3-Clause, the vendored cmocka CMake modules are BSD, and cmocka
    itself is Apache-2.0. There is no copyleft anywhere in the tree.
    THIRD_PARTY_NOTICES.md records each of those, scopes the MIT grant to the
    first-party firmware so it cannot be read as a copyright claim over
    lib/external/, and states plainly that the DCC-EX protocol here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
2026-08-24 docs: record why the DCC protocol itself needs no licence
    "Is DCC a licensed protocol?" is a reasonable thing to wonder about a project
    that puts a command station's signal on rails, and the answer is not obvious
    from outside. Checking it took a while, so record the result next to the DCC-EX
    note rather than leave it to be re-derived.
    The short version: the core standards S-9.2 and S-9.2.1 carry no patent or
    sub-licence language whatsoever. The clause people remember is in S-9.3.2,
    RailCom, which is a translated Lenz document -- and it is moot, because all four
    patents it names have expired, the last in July 2022. PicoDCC does not implement
    RailCom regardless.
    What survives is trademark, w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
2026-08-24 docs: add a README
    PicoDCC had no README at all, so the GitHub page rendered an empty body under
    the file list -- on the most substantial of the four layout repos. Anyone landing
    on it had to open CLAUDE.md, which is a working agreement rather than an
    introduction.
    The README covers what the firmware is, the hardware and pin summary, how to
    build both modes, the dual-core split, and the two non-negotiable safety
    constraints -- flash writes stalling both cores into a DC fallback, and keeping
    diagnostics off the DCC-EX UART. Those two earn their place on the front page
    because both are ways a newcomer can make a locomotive move when nobody asked.
    It is deliberately a front door, not a duplic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
2026-08-24 ci: keep the GitHub Actions versions current with Dependabot
    The workflow pins actions/checkout@v4 and nothing tells us when that tag stops
    being maintained. The failure mode is a deprecated action or runner image
    breaking CI on an unrelated PR, which is the worst moment to discover it.
    Monthly, grouped into a single PR so it is one review rather than a trickle.
    Git submodules are deliberately excluded. LVGL is pinned on purpose, and bumping
    it is a firmware change that needs the hardware build and a look at a real
    display -- not something to merge on a green host suite. The Pico SDK and ARM
    toolchain live outside the repository entirely, so Dependabot cannot see them;
    docs/bench-machine-s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
2026-08-24 Say on the wire when power is cut, and keep the error LED lit (#4, #42) (#59)
    Every path that cuts power because something is wrong now sends the
    standard DCC-EX power notification: the 100ms timing violation, either
    track's PIO failure, the Core 1 heartbeat cutoff, and an overcurrent
    trip. Before this the layout went dark and the wire stayed quiet, and a
    host had no way to tell a working station from one with both tracks
    unpowered.
    The Core 1 half was what left this open: DCCEX_RESPONSE is a blocking
    uart_puts, and one in the DCC hot path is the very stall the timing
    monitor exists to catch. So Core 1 sets a latch and Core 0 drains it in
    dccexLoop(). Announced once per cutoff, not once per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
    [pico_dcc_controller_tests.cpp]
2026-08-25 Emit 128-step speed packets, with a per-loco 28-step fallback (#8)
    The station converted every throttle command down to a 28-step packet, so
    effective resolution on the track was one distinct speed per 4.6 units of
    the 0-126 value a host sends. Any smaller change produced a byte-identical
    packet and the decoder never saw it -- which is coarser than the
    orchestrator's braking model and its crawl_speed_step assume.
    128-step packets are now the default: S-9.2.1 advanced operations, 0x3F
    followed by (direction << 7) | value, where value 0 is a controlled stop,
    1 is the emergency stop, and 2-127 are speed steps 1-126. Note the
    off-by-one against the <t> wire value -- speed 0 encodes as 0, speed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
2026-08-25 Repeat the emergency stop, and hold the locos stopped (#3)
    Two problems on the same few lines of the <!> branch.
    It was sent once, with repeats = 0, against repeats = 3 for an ordinary
    throttle change. DCC is an unacknowledged broadcast over a dirty rail
    joint, and the emergency stop is precisely the packet you would want
    repeated hardest. It now goes out DCC_ESTOP_BROADCAST_REPEATS times.
    That constant is 5, higher than the 3 an explicit command gets, because
    this is the only packet a locomotive the station has never heard of will
    ever receive: after a reboot the loco table is empty, but decoders still
    hold the speed they were last given, and for those the broadcast is the
    only thing that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
    [pico_dcc_controller_tests.cpp, pico_dcc_locos_tests.cpp]
2026-08-26 Drop the repo's duplicate pr skill (#63)
    * Drop the repo's duplicate pr skill
    The global ~/.claude/skills/pr and this one were near-identical prose, and the
    global one carried "a repo with its own pr skill overrides this one". In
    practice the global one loads anyway, so the repo-specific content here never
    reached the session — a silent loss, not a saving. Same removal as
    bazauto/layout-orchestration#182.
    Everything it added is already in CLAUDE.md: both cmake presets, and the rule
    that CI does not cross-build firmware so the pico preset must be run locally.
    One term was about to be narrowed by the deletion. The skill's trigger list for
    that firmware build named PicoDCCDisplay; CLAUDE.m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
2026-08-27 Fill the config sector exactly, and assert it at compile time (#64)
    `pico_config_t` was 3996 bytes, not the 4096 its `reserved[3960]` array claimed
    to pad it to. `save()` hands the whole struct to `flash_range_program`, which
    requires a byte count that is a multiple of the 256-byte flash page and
    hard-asserts otherwise.
    That assert fired at the worst point in the sequence: after
    `multicore_lockout_start_blocking()` had halted Core 1, after interrupts were
    disabled, and after the sector had already been erased. Core 1 never resumed, so
    the DCC signal never resumed -- and per rule 1, decoders that lose the signal
    fall back to DC mode, which on a powered track means full speed. The config was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
2026-08-27 Stop Core 1 waiting on locks in the DCC hot path (#65)
    Rule 4 says use `sem_try_acquire()` rather than a blocking acquire, because
    blocking Core 1 corrupts DCC timing. Three paths ignored that.
    **The emergency stop echo held the loco lock across up to 50 UART writes.**
    `DCCEX_RESPONSE` is `uart_puts(uart0, ...)`, which blocks until the bytes are
    clear. Each `<l ...>` is about 16 bytes, so a full table at 115200 baud held
    `locos_lock` for 70-90ms. For all of that Core 1 was parked in
    `getNextReminder()` emitting no DCC at all, within 10-30ms of the station's own
    100ms timing-violation cutoff -- during an emergency stop, which is the worst
    moment to be near that line. The margin degraded with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
2026-08-27 Idle on '1' bits when the FIFO runs dry, instead of parking the pin (#66)
    `.wrap` targeted `pull block`, and a stalled PIO instruction holds the pin at its
    last side-set value. An empty TX FIFO was therefore not "the signal stops", it
    was one polarity held for as long as the FIFO stayed empty. An H-bridge driven
    from that pin puts DC on the rails, and a decoder that loses the alternating
    waveform falls back to DC mode, which on a powered track means full speed.
    The FIFO does run dry in normal operation, so "keep it fed" was a load-bearing
    safety strategy that was written down nowhere. #35 fixing the pacing made it less
    likely, not impossible, and moved which rail was hot rather than removin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
    [pico_dcc_pio_tests.cpp]
2026-08-27 Correct the test counts and stop blaming Git Bash for the toolchain fault (#67)
    Three stale or wrong claims, all found by tripping over them.
    **The test count table was stale.** #64, #65 and #66 added seven tests between
    them and none updated `docs/architecture.md`, which carries the authoritative
    per-suite table. Counted by running every suite: 288 total, with Locos 36, Config
    Storage 12 and PIO Wire Format 21. `.claude/agents/verify.md` was further adrift
    still, telling the verify agent to expect 10 suites and 145 tests -- so an agent
    finding 11 and 288 would have reported a discrepancy that was the doc's fault.
    It now also says to update the table in the same PR, which is what should hav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
2026-08-27 Discard a zero-byte-count header, and send the real idle packet (#69)
    A bench session left the main track emitting no DCC packets at all. Decoding
    the capture (`docs/DCC_Broken.png`) the rails carried
    `... 3F 80 BB | 00 00 | 0E 04 03 3F ...` with no preamble anywhere -- the raw
    32-bit PIO words themselves, `0E` being DCC_MAIN_PREAMBLE and `04` being
    length+1. Every locomotive held its last commanded speed until the board was
    rebooted.
    A packet is one or two words. If the FIFO slips by one, the state machine pulls
    a packet's *second* word at `start` and reads it as a header. An idle packet's
    second word is 0xFF000000: preamble 255, byte count 0. `jmp x--` post-decremented
    that 0 to 0xFFFFFFF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
    [pico_dcc_pio_tests.cpp]
2026-08-28 Ones-complement the accessory address high bits (#15) (#72)
    * Ones-complement the accessory address high bits (#15)
    `getRawDccAccessoryCmd()` built the second byte of a basic accessory packet
    without ones-complementing the AAA field, which NMRA S-9.2.1 requires and which
    DCC-EX implements as a trailing `^ 0xF8`.
    The issue reported this as affecting addresses of 64 and above. It was worse
    than that: a conforming decoder complements AAA back, so an uninverted `000`
    was read as `111` and *every* accessory command landed 448 addresses high.
    `<a 1 0 1>` drove decoder 449. Accessory control has never reached the
    commanded decoder at any address.
    The fix is the same expression DCC-EX emits, whic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
    [pico_dcc_packet_tests.cpp, pico_dcc_wire_format_tests.cpp]
2026-08-28 Replace findLoco() with a snapshot-returning getLoco() (#37) (#73)
    findLoco() took the lock, found the element, released the lock, and then
    returned a raw pointer into the vector. The lock protected the search and
    nothing else, so the caller was handed something that required the lock with
    no way to hold it -- directly against rule 5 in CLAUDE.md.
    `locos.reserve(MAX_LOCO)` covered the reallocation case, but not the one that
    actually bites: the `erase` in forgetLoco() and getNextReminder() shifts every
    later element down, so the pointer silently began describing a different
    locomotive. getNextReminder() runs on Core 1, so the invalidating write really
    does come from the other core.
    getLoco(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
    [pico_dcc_controller_tests.cpp, pico_dcc_locos_tests.cpp]
2026-08-28 Build diagnostic entries in the ring slot, under the lock (#18) (#74)
    log_diagnostic() assembled every entry in a function-level
    `static diagnostic_msg_t` shared by both cores, filled in *before* the lock was
    taken, and then copied into the circular buffer. The lock inside diag_log_add()
    protected the buffer; nothing protected the static.
    Core 0 and Core 1 both log. A Core 1 call landing midway through Core 0's copy
    loops committed a hybrid entry: one core's level and timestamp against the
    other's component string, or a message spliced from both. The entry that landed
    in the log was a record of an event that never happened -- and it was least
    trustworthy exactly when the log matters most, s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
2026-08-28 Add a UART burst loss test to the DCC-EX probe (#6) (#78)
    #6 asked for display.loop() to be instrumented and its worst case logged. This
    measures the outcome instead, from the outside, with no firmware change: send N
    commands and count the replies. Framing is the only structure DCC-EX gives us --
    no sequence number, no checksum -- so a frame count is the whole measurement.
    --repeat N sends the burst; --pace MS throttles it, which turns a pass/fail into
    a threshold. How many frames one command answers with is measured from a
    calibration send rather than assumed, since <#> answers with one frame and <s>
    with three.
    Two things the harness must not do, both of which it did while being written: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
2026-08-28 The accessory off packet is deliberately absent, not missing (#15) (#79)
    I documented the lack of an accessory off packet as the open, hardware-damage
    half of #15: DCC-EX follows the on packet with a C-cleared one 100ms later, and
    a solenoid decoder that holds its coil while C is asserted would never be told
    to release it.
    That reasoning is right for solenoid motors and wrong for the hardware this
    layout has. Westgate Hollow runs Cobalt IP Digital throughout -- slow-action
    stall motors with their own decoder, which take a direction and hold position
    themselves. There is no coil to release. To a Cobalt the off packet is not a
    no-op, it is another command, and sending it can move the point.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
    [pico_dcc_wire_format_tests.cpp]
2026-08-28 Read the diagnostic log off the board over SWD (#38) (#81)
    The 30-entry ring lives in RAM and was only ever visible on the LCD.
    docs/README.md tells whoever meets the FIFO-slip fault to "capture the
    diagnostic log before rebooting", and until now the only way to do that was to
    photograph the screen -- which is why that fault still has no captured evidence.
    `bash scripts/bench.sh log` halts once, dumps g_diag_log_buffer, resumes, and
    decodes: level, milliseconds since boot, component, message, oldest first, with
    a tally by severity. It is also the telemetry channel for #38 -- the heap
    sampler will log through LOG_INFO, the layout runs for a few hours, and this
    reads the trend back in a singl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
2026-08-28 Make the timing violation report the truth about itself (#80) (#82)
    * Make the timing violation carry its own numbers (#80)
    "DCC timing violation detected" says a gap exceeded 100ms and nothing else.
    It cannot distinguish a transmitter that stalled from one that never
    started, and those want opposite fixes -- which is where #80 stalled.
    The message now carries the gap and whether any packet has been sent at all,
    and Core 1 logs when its loop first runs. The entry timestamp is the
    measurement there: the gap check measures against core1_start_ms before the
    first packet goes out, so without it a violation timestamp cannot be turned
    into a gap.
    snprintf into a static, not a stack buffer -- th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
    [pico_dcc_controller_tests.cpp]
2026-08-28 Sample the heap into the diagnostic log (#38) (#85)
    #38 asks whether the heap high-water mark is flat or creeping over a long
    session. The DCC-EX path allocates per received command, and main_cmd_queue is
    a std::queue<raw_dcc_cmd_t> -- a std::deque underneath, which allocates its
    blocks. On a target with no MMU, where the heap grows towards the stack and
    nothing handles allocation failure, that is the question worth answering before
    deciding whether anything needs changing.
    diag_sample_heap() logs used, free and arena from mallinfo() every ten minutes,
    which gives roughly five hours of trend across the 30-entry ring. `used` answers
    "is anything leaking"; `arena` answers "is it fragmenting",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
    [mocks.cpp, mocks.h, pico_diagnostic_tests.cpp]
2026-08-28 Read the diagnostic log without resetting or halting the board (#86)
    * Read the diagnostic log without resetting or halting the board
    `bench.sh log` ended with `reset run`, inherited from the `config` mode where
    rebooting after reading flash is harmless. For a log dump it destroys the thing
    being read.
    Every dump rebooted the board, so every dump showed a fresh boot. Uptime never
    accumulated past the gap between two reads, and anything on a long interval
    could never produce a second entry no matter how long you waited. The #38 heap
    sampler runs on ten minutes; reading the log twice, seven minutes apart, showed
    the same four entries with the same timestamps both times. That looked like a
    br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
2026-08-29 Initialise currentPacket and bufferLength explicitly (#38) (#88)
    Both are initialised at their declarations, which is correct, but the
    constructor sets every other member and so reads as the place initialisation
    happens. reset() does `if (currentPacket) delete currentPacket;` and the
    safety of that delete rests entirely on the declaration initialiser -- which
    the next reader has to go and check the header to discover.
    No behaviour change; they already held these values. This is the loose end
    #38 raised alongside the heap question.
2026-09-28 Import the carrier PCB design, under CERN-OHL-P-2.0 (#105)
    The KiCad project for the board the firmware runs on lived outside the
    repo (and CircuitDesign was git-ignored), so nothing tied the pinout doc
    to the copper. It now lives in hardware/, unchanged from the files the
    boards were built from.
    - hardware/: project, schematic, board, the BTS7960 project symbol, BOM,
    and fab/rev-1.0/ -- the Gerbers and drill files as plotted 2025-04-26.
    Per-user and generated KiCad files (.kicad_prl, fp-info-cache, backups,
    lock files) are ignored, as is Gerber/, KiCad's plot directory, so a
    fresh plot is never mistaken for the fab record.
    - hardware/fab/** is -text, so the record is stored byte-fo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
    [PicoDCC-B_Cu.gbr, PicoDCC-B_Mask.gbr, PicoDCC-B_Paste.gbr, PicoDCC-B_Silkscreen.gbr, PicoDCC-Edge_Cuts.gbr, PicoDCC-F_Cu.gbr, PicoDCC-F_Mask.gbr, PicoDCC-F_Paste.gbr]
