bazauto/PicoDCC/(notices)

Notices in the files:
THIRD_PARTY_NOTICES.md:
PicoDCC itself is released under the MIT Licence â€” see [`LICENSE`](LICENSE). That licence
